EMDCYY/Multi-Core-HD-Video-Processing-Platform/circuit/DSP-DaughterBoard/系统框图/基于FPGA+多DSP的高清视频处理平台（不含DM642）.jpg

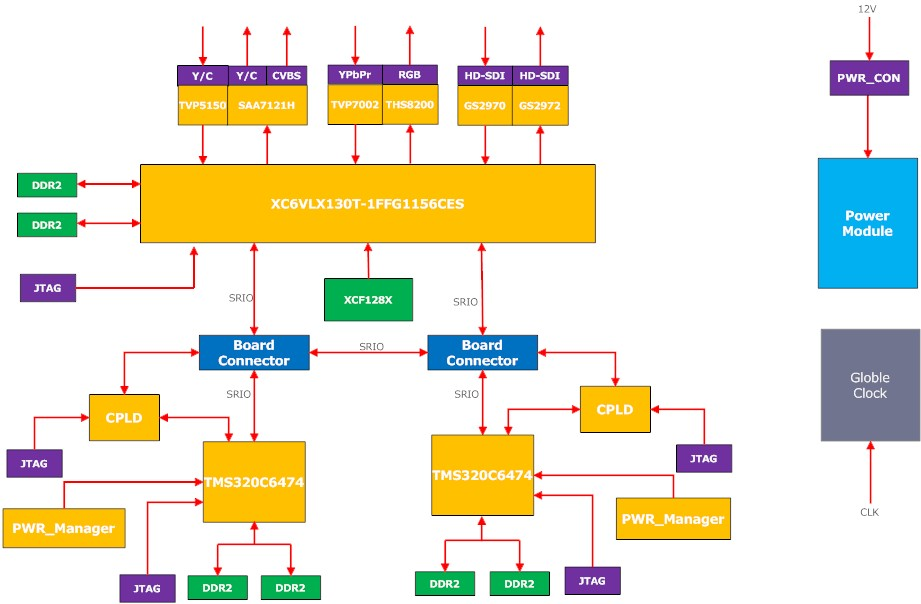
circuit/DSP-DaughterBoard/系统框图/基于FPGA+多DSP的高清视频处理平台（不含DM642）.jpg
