EMDCYY/Multi-Core-HD-Video-Processing-Platform/circuit/DSP-DaughterBoard/系统框图/子卡PCB图.jpg

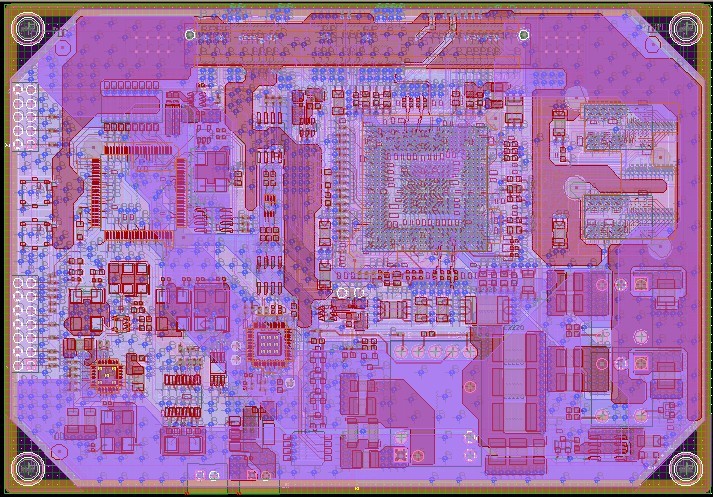
circuit/DSP-DaughterBoard/系统框图/子卡PCB图.jpg
