EMDCYY/Multi-Core-HD-Video-Processing-Platform/README.md

# Multi-Core-HD-Video-Processing-Platform
