EMDCYY/Multi-Core-HD-Video-Processing-Platform/circuit/DSP-DaughterBoard/系统框图/CAD布局图.jpg

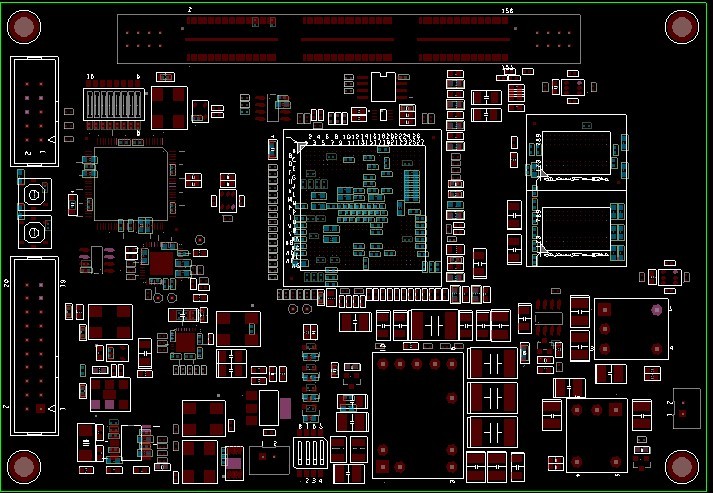
circuit/DSP-DaughterBoard/系统框图/CAD布局图.jpg
