EMDCYY/Multi-Core-HD-Video-Processing-Platform/circuit/DSP-DaughterBoard/price.xls

 | 器件名称 | 型号 | 封装类型 | PCB Footprint | 数量 | 单价 | 总计 | 备注
背 板 | DSP | TMS320DM642AGNZ7 | BGA | DM642_BGA548 | 1 | $76.84
 | Virtex-6系列FPGA | XC6VLX130T-1FFG1156CES | BGA | FPGA_FFG1156C | 1 | $1023.89 |  | Xilinx公司，考虑与DSP子卡的SRIO扩展
 | FPGA配置PROM | XCF128XFTG64C | FTG-64 | XCF128X_FTG64C | 1 | $50.00 |  | 128M可编程ROM，-40°~+85°
 | 普通视频解码器 | TVP5150AM1PBS | TSQFP-32 | TVP5150AM1_TSQFP32 | 1 | $3.31 |  | 低功耗，支持656.3和656.4时序，输出接VP1的A通道
 | 普通视频编码器 | SAA7121H | QFP-44 | SAA7121H_QFP44 | 1 | ￥20.00 |  | 接收VP2的8位BT.656数字信号输入
 | 高清RGB视频解码器 | TVP7002PZP | TQFP-100 | TVP7002_TSQFP100 | 1 | $4.41 |  | 接收高清视频信号输入
 | 高清RGB视频缓冲器 | THS7327PHP | TSQFP-48 | THS7327_TSQFP48 | 2 | $5.66 |  | 在高清解码器之前作为数据缓冲
 | 高清RGB视频编码器 | THS8200PFP | TQFP-80 | THS8200_TSQFP80 | 1 | $5.15 |  | 经由DB-15接口，输出高清RGB信号
 | HD-SDI解码器 | GS2970-IBE3 | BGA-100 | GS2970_BGA100 | 1 | $107.46 |  | GENNUM公司
 | HD-SDI编码器 | GS2972-IBE3 | BGA-100 | GS2972_BGA100 | 1 | $112.38
 | HD-SDI视频缓冲器 | GS2974BCNE3 | QFN-16 | GS2974B_QFN16 | 1 | $52.94
 | HD-SDI输出驱动 | GS2978CNE3 | QFN-16 | GS2978_QFN16 | 1 | $16.06
 | SDRAM | MT48LC4M32B2TG-6IT | TSOP-86 | MT48LC4M32B2_TSOP86 | 2 | $6.64 |  | 4M*32bit，并联成为64bit，166MHz
 | Flash | AM29LV033C-70EI | TSOP-40 | Am29LV033C_TS040 | 1 | $4.81 |  | 32Megabit(4M*8-Bit)CMOS Flash Memory，Access time 70ns，AMD公司
 | DDR2 | MT47H64M16HR-187EITH | FBGA-84 | MT47H64M16_FBGA84 | 2 | $11.30 |  | 1G容量，8 Meg x 16 x 8 banks，1.875ns
 | UART | TL16C752BPT | TSQFP-48 | TL16C752B_TSQFP48 | 1 | $4.40 |  | 并行-串行，接PC显示
 | RS-232驱动/接收器 | MAX3243EEAI | SSOP-28 | MAX3243_SSOP28 | 1 | $6.75 |  | 适用温度范围大-40℃~+85℃
 | 总线收发器 | SN74LVC2T45DCUT | TSSOP-8 | SN74LVC2T45_TSSOP8 | 2 | $0.95 |  | 连接YPbPr输入的同步信号
 |  | SN74LVT16245BDGGR | TSSOP-48 | SN74LVT16245B_TSSOP48 | 4 | $0.75 |  | 连接EMIF与外部Flash，增强驱动能力
 | 压控开关 | 74CBTLV1G125DCKR | SC70 | 74CBTLV1G125_DCK | 4 | $0.35 |  | 1号使能引脚OE#始终有效
 | 电感、磁珠 | BLM21PG221SN1D | 0805 | L0805 | 50 | $0.03 |  | 220Ω@100MHz
 |  | BLM18AG102SN1D | 0603 | L0603 | 2 | $0.04 |  | 1000Ω@100MHz
 |  | BLM41PG750SN1L | 1210 | L1210 | 8 | $0.27 |  | 75Ω@100MHz，用于大电流场合。新中发电子市场1213柜台。
 |  |  |  | L0603 |  |  |  | 6.2nH;5.6nH
 |  |  |  | L0805 |  |  |  | 2.2uH;27uH
 | 晶振 | 25MHz | 四脚贴片 | OSCCC_SMD2520 | 1 | ￥5.00 |  | SiTime公司，2.5*2.0*0.75(mm)
 |  | 50MHz |  |  | 1
 |  | 100MHz |  |  | 1
 |  | 27MHz | 两脚贴片，ABM7-27.000MHZ-D2Y-T | XTAL | 3 | $1.05 |  | Abracon公司，AMB7封装，6.0 x 3.5 x 1.4mm
 | PLL时钟发生器 | ICS512MI | SOIC-8 | ICS512_SOIC8 | 1 | ￥25.00 |  | 时钟乘法器
 |  | CDCE949PW | TSSOP-24 | CDCE949_TSOP24 |  | $3.90 |  | 可编程，多个PLL输出
 |  | CDCM61001RHBT | QFN-32 | CDCM61001_QFN32 |  | $14.00 |  | 可编程，一个PLL输出
 | 压控晶体振荡器 | PI6CX100-00WE | SOIC-8 | PI6CX100_00_SOIC8 |  | $6.00 |  | VP模块左下方的STCLK 27MHz输入；支持19.44到40MHz
 | 按键 | 四脚 | SW-DIP4 | SW_DIP4 | 2 |  |  | 系统复位、FPGA复位
 | 拨码开关 | 四位八脚 | SW-DIP8 | SW_DIP8 | 1 | ￥1.50 |  | 用于手动进行初始化配置
 | 接口 | VGA接口（母座） | DB-15 | VGA15 | 2 |  |  | 高清YPbPr信号输入、高清RGB输出
 |  | BNC接口 W58-124-9039910 |  | BNC4 | 3 |  |  | HD-SDI输入、HD-SDI输出、PAL输入、CVBS输出，ITT Industries公司
 |  | S端子接口 | 四脚 | 749181_117 | 2 |  |  | 四针，Y/C输出，深圳奥迪亚公司
 |  | JTAG | DIP-14 | HDR254_2X7 | 2 |  |  | 14脚双列直插式，无特定厂家
 |  | RS-232接口（公头） | DB-9 | 788750 | 1 |  |  | RS-232输出接口,Hirose公司
 |  | 12V电源输入接口 | 502-RASM712 | PWC0103 | 1 | ￥15.00 |  | 贴片，Switchcraft公司直流电源连接器，Pin Size=2.5mm/0.1inch
 |  | 子卡接口（基板） | QFS-078-0425-L-D-PC8 | QFS_078_0425_L_D_PC8 | 2 | ￥110.00 |  | Samtec公司高速接口
 | 电阻 | 22排阻 | SSOP-8 | 8P4R_0402_CN_42 | 24
 |  | 33排阻 |  |  | 24 |  |  | 8P4R，单个电阻为0402封装
 |  |  |  | R0402 | 56 |  |  | 0;4.7;10;18;22;33
 |  |  |  | R0603 | 224 |  |  | 37.4;49.9;56;75;100;105;127;200;209;240;330;360;470;698;732;750;1K;1.5K;2K;2.08K;2.2K;2.21K;3.74K;4.7K;4.75K
 |  |  |  | R0805 | 7 |  |  | 10K;12.1K;17.4K;20.5K;31.6K;71.5K;100K;120K
 | MOSFET | BSS138 | SOT23 | SOT23 | 2 | ￥2.00 |  | FPGA配置显示LED的压控器
 | 一转四差分时钟驱动器 | SN65LVDS104PW | TSOP-16 | SN65LVDS104_TSOP16 | 1 | $2.78 |  | 一对差分时钟信号转四对差分时钟信号
 | IIC配置存储器 | AT88SC0104C-SI | SOIC-8 | AT88SC0104C_SOIC8 | 1 | $0.68 |  | 1-KBit
 | 电源芯片 | PTH12040WAD | EVF20 | PTH12040W_EVF20 | 1 | $48.90 |  | 12V→5V，50A，TI公司
 |  | PTH08T240FAD | EBS11 | PTH08T240F_EBS11 | 3 | $15.09 |  | 5V降压，10A，TI公司
 |  | PTH05050WAS | EUU6 | PTH05050W_EUU6 | 3 | $9.65 |  | 5V降压，6A，TI公司
 |  | LM317MDCYR | SOT223 | LM317M_SOT223 | 1 | $0.37 |  | 5V→1.9V，TI公司
 | DSP电源管理芯片 | TPS54310PWP | TSOP-20 | TPS54310_TSOP20 | 2 | $3.97 |  | TI公司
 | 手动复位芯片 | SN74LVC1G123DCTR | SSOP-8 | SN74LVC1G123_DCT | 1 | $0.37
 | 电容 |  |  | C0402 | 601 |  |  | 15pF;16pF;18pF;100pF;120pF;180pF;560pF;1nF;2.7nF;3.9nF;4.7nF;10nF;39nF;47nF;0.1uF;0.22uF;470nF
 |  |  |  | C0603 | 33 |  |  | 1uF
 |  |  |  | C0805 | 41 |  |  | 0.1uF;4.7uF;10uF;47uF
 |  |  |  | C1206 | 12 |  |  | 22uF;47uF
 |  | 6TPB47M | B型 | C3258_P | 49 | $1.18 |  | 4.7uF;10uF;22uF;33uF;47uF;100uF;180uF;330uF;1000uF。低等效串联电阻，导电性高分子钽电容器，SANYO公司，,20pcs起售
 |  |  |  | C7343_P | 16 |  |  | 47uF;100uF;150uF;330uF;560uF。低等效串联电阻，导电性高分子钽电容器，SANYO公司，,20pcs起售
 | 二极管 | 发光二极管 |  | LED0805 | 7 |  |  | 2个Green；5个Red
 |  | 雪崩二极管SMBJ15A | DO-214AA (SMB J-Bend) | SMBJ15A_DIO | 1 | $0.20 |  | 12V电源输入处
 | 测试点 |  |  | TestPoint | 39
 | 子卡支撑柱
 | 总计 |  |  |  |  | $1700.00
子 卡 | 器件名称 | 型号 | 封装类型 | 数量 | 单价 | 总计 | 备注
 | 插槽 | QMS-078-01-SL-D-EM2-PC8 | QMS-078-01-SL-D-EM2-PC8 | 1 | 110 | ￥110.00
 | PLL时钟发生器 | CDCE906 | TSSOP20_CDCE906 | 1 | 5 | ￥5.00
 |  | CDCL6010 | QFN48_CDCL6010 | 1 | 100 | ￥100.00
 |  | CDCM61001 | QFN32_CDCM61001 | 1 | 80 | ￥80.00
 | 晶振 | 50 MHz-SiT8102 | X4-0705 | 1 | 5 | ￥5.00
 |  | 66 MHz-SiT8102 | X4-0705 | 1 | 5 | ￥5.00
 |  | 12 MHz-SiT8102 | X4-0705 | 1 | 5 | ￥5.00
 |  | 125MHz-Sit8102 | X4-0705 | 1 | 5 | ￥5.00
 |  | 24MHz_ABM7 | ABM7 | 1 | 5 | ￥5.00
 |  | 25MHz-SiT8102 | X4-0705 | 1 | 5 | ￥5.00
 |  | SiT9102 | X6_0705 | 1 | 5 | ￥5.00
 | 电平转换器 | SN65LVDS9638 | MSOP8_LVDS9638 | 1 | 5 | ￥5.00
 |  | SN65LVDS1DBV | SOT23-5 | 2 | 5 | ￥10.00
 |  | SN65LVDT2D | SOIC8_SN65LVDT2D | 1 | 5 | ￥5.00
 | CPLD | EPM240GT100C5N | TQFP100 | 1 | 20 | ￥20.00
 | DDR2 | MT47H64M16HR-3EL | FBGA-84 | 2 | 30 | ￥60.00
 | DSP | TMS320C6474ZUNF | FCBGA561_ZUN | 1 | 1600 | ￥1600.00
 | FLASH | CAT24C256WI-G | SO8WN_CAT24C | 1 | 10 | ￥10.00
 |  | AT24C1024W10SU27 | SO8WN_AT24C | 1 | 10 | ￥10.00
 | I2C | PCA9306 | VSSOP8DC1 | 1 | 8 | ￥8.00
 | POWER | LM317DCY | DCY4 | 1 | 2 | ￥2.00
 |  | PTH08T240F | PTH08T240F | 1 | 100 | ￥100.00
 |  | PTH04070WAH | EVD5_PTH04070 | 2 | 50 | ￥100.00
 | POWMGT | TPS3808G09DBVRG4 | SOT23-6 | 3 | 20 | ￥60.00
 | TOTAL |  |  |  |  | ￥2320.00
