EMDCYY/Multi-Core-HD-Video-Processing-Platform/(list of files, cad)

Other CAD files:
circuit/DSP-DaughterBoard/自制封装/PTH04070WAH.psm
circuit/DSP-DaughterBoard/自制封装/capc5750x230.psm
circuit/DSP-DaughterBoard/自制封装/capmp3216x180.psm
circuit/DSP-DaughterBoard/自制封装/oscsc254p500x700x160-6.psm
circuit/DSP-DaughterBoard/自制封装/oscsc508p500x700x180-4.psm
circuit/DSP-DaughterBoard/自制封装/qfn50p700x700x80-49b.psm
circuit/DSP-DaughterBoard/自制封装/soic127p600x175-8.psm
circuit/DSP-DaughterBoard/自制封装/soic127p780x200-8.psm
circuit/DSP-DaughterBoard/自制封装/sot95p279x142-5.psm
circuit/DSP-DaughterBoard/自制封装/sot95p280x145-6a.psm
circuit/DSP-DaughterBoard/自制封装/spbgan561.psm
circuit/DSP-DaughterBoard/自制封装/tsop65p400x135-8.psm
circuit/DSP-DaughterBoard/自制封装/tsop65p491x111-8.psm
circuit/DSP-DaughterBoard/自制封装/tsop65p640x110-14.psm
circuit/DSP-DaughterBoard/自制封装/元件焊盘及封装/74CBTLV1G125——压控开关/74cbtlv1g125_dck.psm
circuit/DSP-DaughterBoard/自制封装/元件焊盘及封装/8引脚排阻/8p4r-0402_cn-42.psm
circuit/DSP-DaughterBoard/自制封装/元件焊盘及封装/AT88SC0104——IIC存储器/at88sc0104c_soic8.psm
circuit/DSP-DaughterBoard/自制封装/元件焊盘及封装/Am29LV033C——flash/am29lv033c_ts040.psm
circuit/DSP-DaughterBoard/自制封装/元件焊盘及封装/CDCE949——可编程PLL/cdce949_tsop24.psm
circuit/DSP-DaughterBoard/自制封装/元件焊盘及封装/CDCM61001——时钟发生器/cdcm61001_qfn32.psm
circuit/DSP-DaughterBoard/自制封装/元件焊盘及封装/DM642/dm642_bga548.psm
circuit/DSP-DaughterBoard/自制封装/元件焊盘及封装/FPGA/fpga_ffg1156c.psm
circuit/DSP-DaughterBoard/自制封装/元件焊盘及封装/GS2970——HD-SDI解码器/gs2970_bga100.psm
circuit/DSP-DaughterBoard/自制封装/元件焊盘及封装/GS2972——HD-SDI编码器/gs2972_bga100.psm
circuit/DSP-DaughterBoard/自制封装/元件焊盘及封装/GS2974B——HD-SDI输入缓冲器/gs2974b_qfn16.psm
circuit/DSP-DaughterBoard/自制封装/元件焊盘及封装/GS2978——HD-SDI输出驱动/gs2978_qfn16.psm
circuit/DSP-DaughterBoard/自制封装/元件焊盘及封装/ICS512——时钟乘法器/ics512_soic8.psm
circuit/DSP-DaughterBoard/自制封装/元件焊盘及封装/LED0805/led0805.psm
circuit/DSP-DaughterBoard/自制封装/元件焊盘及封装/LM317M——5V-1.9V电压转换/lm317m_sot223.psm
circuit/DSP-DaughterBoard/自制封装/元件焊盘及封装/LM317M——5V-1.9V电压转换/null.psm
circuit/DSP-DaughterBoard/自制封装/元件焊盘及封装/MAX3243——RS-232协议收发器/max3243_ssop28.psm
circuit/DSP-DaughterBoard/自制封装/元件焊盘及封装/MOSFET三极管/sot23.psm
circuit/DSP-DaughterBoard/自制封装/元件焊盘及封装/MT47H64M16——1GbDDR2/mt47h64m16_fbga84.psm
circuit/DSP-DaughterBoard/自制封装/元件焊盘及封装/MT48LC4M32B2TG-6IT——SDRAM/mt48lc4m32b2_tsop86.psm
circuit/DSP-DaughterBoard/自制封装/元件焊盘及封装/PI6CX100-00——压控晶体振荡器/pi6cx100-00_soic8.psm
circuit/DSP-DaughterBoard/自制封装/元件焊盘及封装/PTH05050W——5V输入电压转换/pth05050w_euu6.psm
circuit/DSP-DaughterBoard/自制封装/元件焊盘及封装/PTH08T240F——5V输入电压转换/pth08t240f_ebs11.psm
circuit/DSP-DaughterBoard/自制封装/元件焊盘及封装/PTH12040W——12V-5V电压转换/pth12040w_evf20.psm
circuit/DSP-DaughterBoard/自制封装/元件焊盘及封装/SAA7121H——编码/saa7121h_qfp44.psm
circuit/DSP-DaughterBoard/自制封装/元件焊盘及封装/SMBJ15A——雪崩二极管/smbj15a_dio.psm
circuit/DSP-DaughterBoard/自制封装/元件焊盘及封装/SN65LVDS104——1路转4路差分信号中继器/sn65lvds104_tsop16.psm
circuit/DSP-DaughterBoard/自制封装/元件焊盘及封装/SN74LVC1G123DCTR——手动复位/sn74lvc1g123_dct.psm
circuit/DSP-DaughterBoard/自制封装/元件焊盘及封装/SN74LVC2T45——双向总线收发器/sn74lvc2t45_tssop8.psm
circuit/DSP-DaughterBoard/自制封装/元件焊盘及封装/SN74LVT16245B——总线收发器/sn74lvt16245b_tssop48.psm
circuit/DSP-DaughterBoard/自制封装/元件焊盘及封装/THS7327——高清视频缓冲器/ths7327_tsqfp48.psm
circuit/DSP-DaughterBoard/自制封装/元件焊盘及封装/THS8200——高清编码/ths8200_tsqfp80.psm
circuit/DSP-DaughterBoard/自制封装/元件焊盘及封装/TL16C752B——UART/tl16c752b_tsqfp48.psm
circuit/DSP-DaughterBoard/自制封装/元件焊盘及封装/TPS54310——DSP电源管理/tps54310_tsop20.psm
circuit/DSP-DaughterBoard/自制封装/元件焊盘及封装/TVP5150AM1——解码/tvp5150am1_tsqfp32.psm
circuit/DSP-DaughterBoard/自制封装/元件焊盘及封装/TVP7002——高清解码/tvp7002_tsqfp100.psm
circuit/DSP-DaughterBoard/自制封装/元件焊盘及封装/XCF128XFTG64C——V-6系列130T FPGA配置PROM/null.psm
circuit/DSP-DaughterBoard/自制封装/元件焊盘及封装/XCF128XFTG64C——V-6系列130T FPGA配置PROM/xcf128x_ftg64c.psm
circuit/DSP-DaughterBoard/自制封装/元件焊盘及封装/接口/DB9/db9.psm
circuit/DSP-DaughterBoard/自制封装/元件焊盘及封装/晶振/两脚/xtal.psm
circuit/DSP-DaughterBoard/自制封装/元件焊盘及封装/晶振/四脚贴片/null.psm
circuit/DSP-DaughterBoard/自制封装/元件焊盘及封装/晶振/四脚贴片/osccc.psm
circuit/DSP-DaughterBoard/自制封装/元件焊盘及封装/测试点/testpoint_s200d90.psm
circuit/DSP-DaughterBoard/自制封装/元件焊盘及封装/电容/C0402/c0402.psm
circuit/DSP-DaughterBoard/自制封装/元件焊盘及封装/电容/C0603/c0603.psm
circuit/DSP-DaughterBoard/自制封装/元件焊盘及封装/电容/C0805/c0805.psm
circuit/DSP-DaughterBoard/自制封装/元件焊盘及封装/电容/C1206/c1206.psm
circuit/DSP-DaughterBoard/自制封装/元件焊盘及封装/电容/C3528_P/c3528_p.psm
circuit/DSP-DaughterBoard/自制封装/元件焊盘及封装/电容/C7343_P/c7343_p.psm
circuit/DSP-DaughterBoard/自制封装/元件焊盘及封装/电感、磁珠/L0603/l0603.psm
circuit/DSP-DaughterBoard/自制封装/元件焊盘及封装/电感、磁珠/L0805/l0805.psm
circuit/DSP-DaughterBoard/自制封装/元件焊盘及封装/电感、磁珠/L1210/l1210.psm
circuit/DSP-DaughterBoard/自制封装/元件焊盘及封装/电阻/R0402/r0402.psm
circuit/DSP-DaughterBoard/自制封装/元件焊盘及封装/电阻/R0603/r0603.psm
circuit/DSP-DaughterBoard/自制封装/元件焊盘及封装/电阻/R0805/r0805.psm
