EMDCYY/Multi-Core-HD-Video-Processing-Platform/(list of files, drawings)

Other design files:
circuit/DSP-DaughterBoard/Schematic/DSPDB.DSN
circuit/DSP-DaughterBoard/Schematic/DSPDB.opj
circuit/FPGA-MotherBoard/DSP_FPGA_PCB.DSN
circuit/FPGA-MotherBoard/dsp_fpga_pcb.opj
circuit/FPGA-MotherBoard/FPGA/DSP_FPGA_PCB.DSN
circuit/FPGA-MotherBoard/FPGA/dsp_fpga_pcb.opj
circuit/FPGA-MotherBoard/FPGA/原理图库.OLB
circuit/FPGA-MotherBoard/FPGA/原理图库.opj
circuit/FPGA-MotherBoard/原理图库.OLB
circuit/FPGA-MotherBoard/原理图库.opj
