EMDCYY/Multi-Core-HD-Video-Processing-Platform/circuit/DSP-DaughterBoard/PCB/art_param.txt

DEVICE-TYPE           GERBER_RS274X
OUTPUT-UNITS          INCHES
FILM-SIZE             2400000 1600000
FORMAT                5.5
ABORT-ON-ERROR        NO
SCALE                 1
SUPPRESS-LEAD-ZEROES  NO
SUPPRESS-TRAIL-ZEROES NO
SUPPRESS-EQUAL        NO
UNDEF-APT-CONT        NO
