EMDCYY/Multi-Core-HD-Video-Processing-Platform/(commit log)

2021-05-04 First public
    [74cbtlv1g125_dck.psm, 8p4r-0402_cn-42.psm, DSPDB.DSN, DSPDB.opj, DSP_FPGA_PCB.DSN, DSP子卡.xlsx, Hampoo_Quotation北京理工_基板和子卡_BOM_吴艳伟_20110525_fix.xls, Hampoo_北京理工_基板和子卡_BOM沟通_20110 524.xls]
2021-05-05 circuit update
    [DSPDB.DSN, DSPDB.opj, DSP子卡.xlsx, Hampoo_Quotation北京理工_基板和子卡_BOM_吴艳伟_20110525_fix.xls, Hampoo_北京理工_基板和子卡_BOM沟通_20110 524.xls, Hampoo_最新生成BOM_DSP子卡_201106014.xls, Hampoo_最新生成BOM_DSP子卡_201106020——DONE.xls, Hampoo_芯片报价_北京理工大学_20110428-fix.xls]
